tinkeringtech/RF-Remote-Receiver/315mhz_i2c_v1.brd

## EAGLE design 315mhz_i2c_v1.brd (2026-11-11)

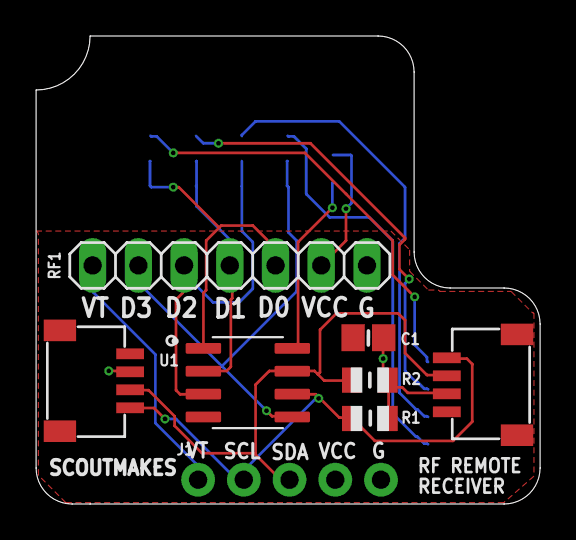
[picture p1: board 315mhz_i2c_v1.brd from above]

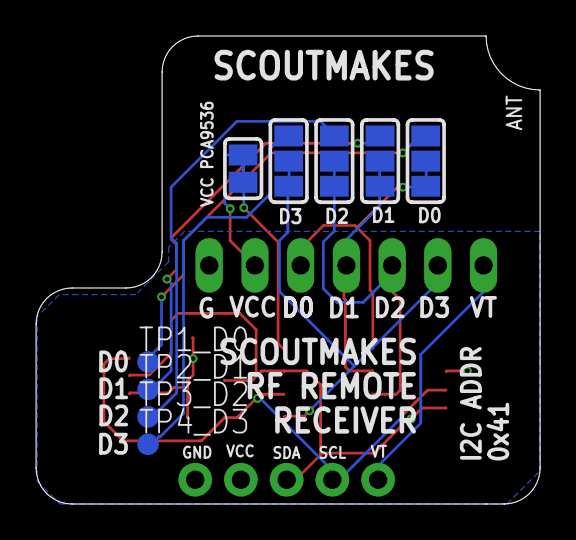
[picture p2: board 315mhz_i2c_v1.brd from below]

Board: 2 copper layers, 28.0 x 26.0 mm, 17 parts (9 on the bottom side), 14 nets.

Parts:
C1: 0.1uF; C0805
CONN3, CONN4: STEMMA_I2C_QT; JST_SH4
HP0, HP1, HP2, HP3: SOLDERJUMPER_2WAY_OPEN_NOPASTE
J1: 1X05_NO_SILK
JPVCC: SOLDERJUMPER_CLOSEDWIRE
R1, R2: 10K; R0805
RF1: MODULE; 1X07
TP1_D0, TP2_D1, TP3_D2, TP4_D3: TPTP12R; TP12R
U1: PCA9536D; SOIC127P599X175-8N

Connections:
D0: HP0.2, HP0.3, RF1.5, U1.1
D1: HP1.2, HP1.3, RF1.4, U1.2
D2: HP2.2, HP2.3, RF1.3, U1.3
D3: HP3.2, HP3.3, RF1.2, U1.5
GND: C1.2, CONN3.1, CONN3.MT1, CONN3.MT2, CONN4.1, CONN4.MT1, CONN4.MT2, J1.5, RF1.7, U1.4
unnamed: HP0.1, TP1_D0.TP
unnamed: HP1.1, TP2_D1.TP
unnamed: HP2.1, TP3_D2.TP
unnamed: HP3.1, TP4_D3.TP
SCL: CONN3.4, CONN4.4, J1.2, R1.1, U1.6
SDA: CONN3.3, CONN4.3, J1.3, R2.1, U1.7
VCC: C1.1, CONN3.2, CONN4.2, J1.4, JPVCC.1, R1.2, R2.2, RF1.6
VCCPCA: JPVCC.2, U1.8
VT: J1.1, RF1.1
